SHIKE888/26h/B站 球杆平衡系统2026.07.29/产品实物图解.png

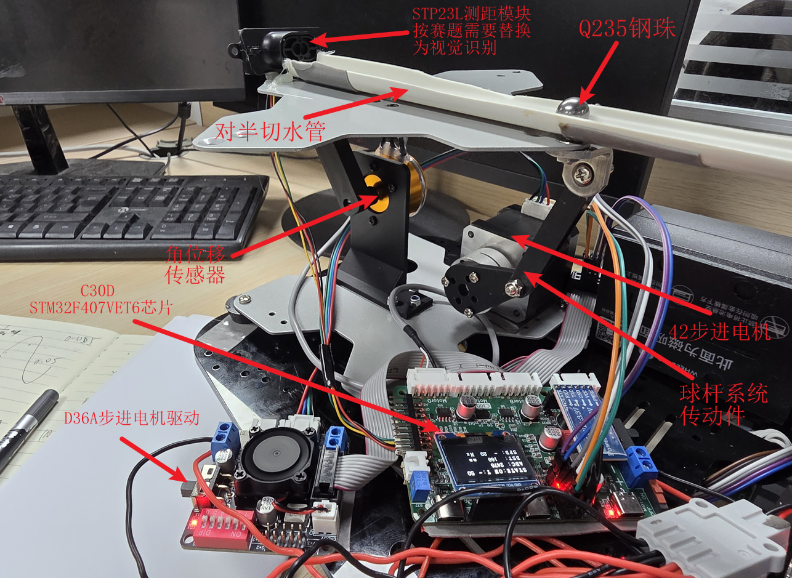
B站 球杆平衡系统2026.07.29/产品实物图解.png
