SHIKE888/26h/B站 球杆平衡系统2026.07.29/硬件方案与效果说明.txt

《球杆平衡控制系统》资料包里仅有球杆系统的代码，用到的物料如下
物料清单：
角位移传感器 * 1
1个42步进电机 * 1
D36A步进电机驱动 * 1
C30D控制板（STM32F407VET6芯片）* 1
STP23L测距模块 * 1
Q235钢珠 * 1
水管 * 1
球杆系统传动件 * 1

效果演示视频可以参考B站，可以改变球的位置，或者球收到干扰后可以回到原点：
https://www.bilibili.com/video/BV1CW3q6rEp6/?spm_id_from=333.1365.list.card_archive.click

巡线部分：
巡线部分的物料是单独的，此部分代码请查看四路红外模块的资料。巡线部分的物流如下，与球杆系统是分开的：
R3X电赛小车底盘 * 1
C30D控制板 * 1
LF04四路红外巡线模块 * 1

其他说明：
这套系统里，小车巡线和球杆平衡控制系统是分离的，两者无通信，是独立的系统。
