SHIKE888/26h/结构/连轴器.SLDPRT

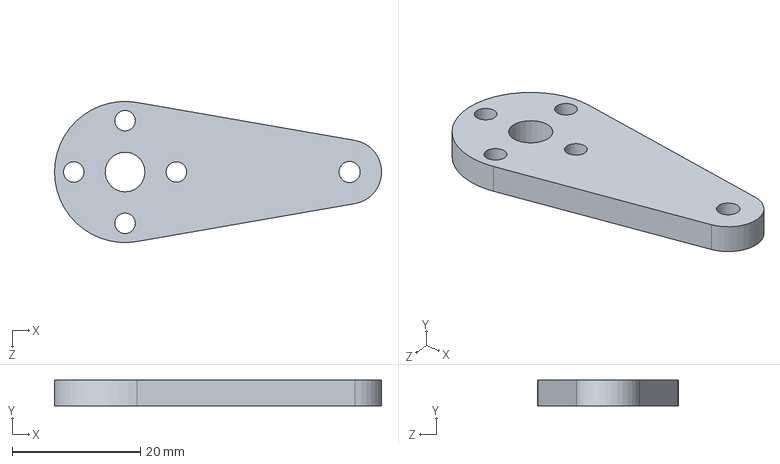
[picture p2: CAD file, 2026-07-30]
结构/连轴器.SLDPRT
51.0 x 4.00 x 22.0 mm
