SHIKE888/26h/结构/固定杆带底法兰.SLDPRT

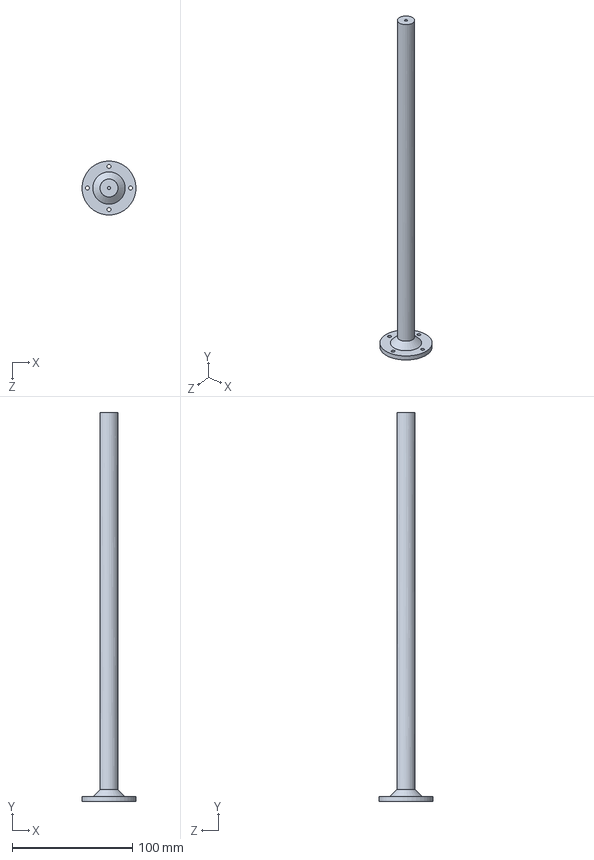
[picture p3: CAD file, 2026-07-29]
结构/固定杆带底法兰.SLDPRT
45.0 x 324.0 x 45.0 mm
