SHIKE888/26h/结构/顶法兰.SLDPRT

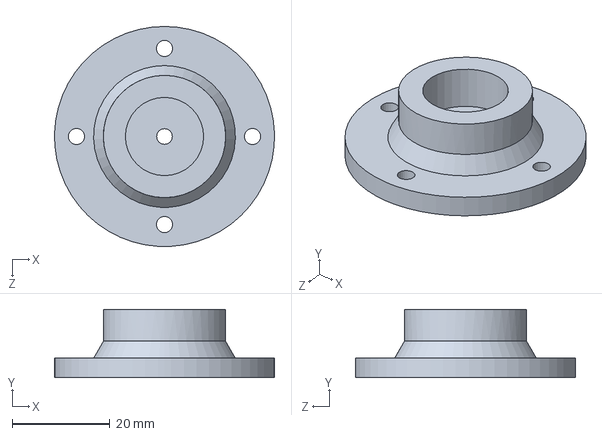
[picture p4: CAD file, 2026-07-29]
结构/顶法兰.SLDPRT
45.0 x 14.0 x 45.0 mm
