SHIKE888/26h/结构/H42装配.SLDPRT

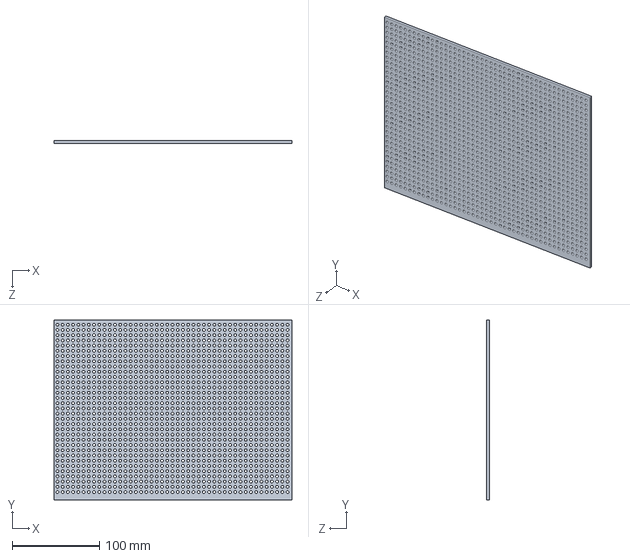
[picture p5: CAD file, 2026-07-29]
结构/H42装配.SLDPRT
273.0 x 206.0 x 3.00 mm
