SHIKE888/26h/结构/顶板.SLDPRT

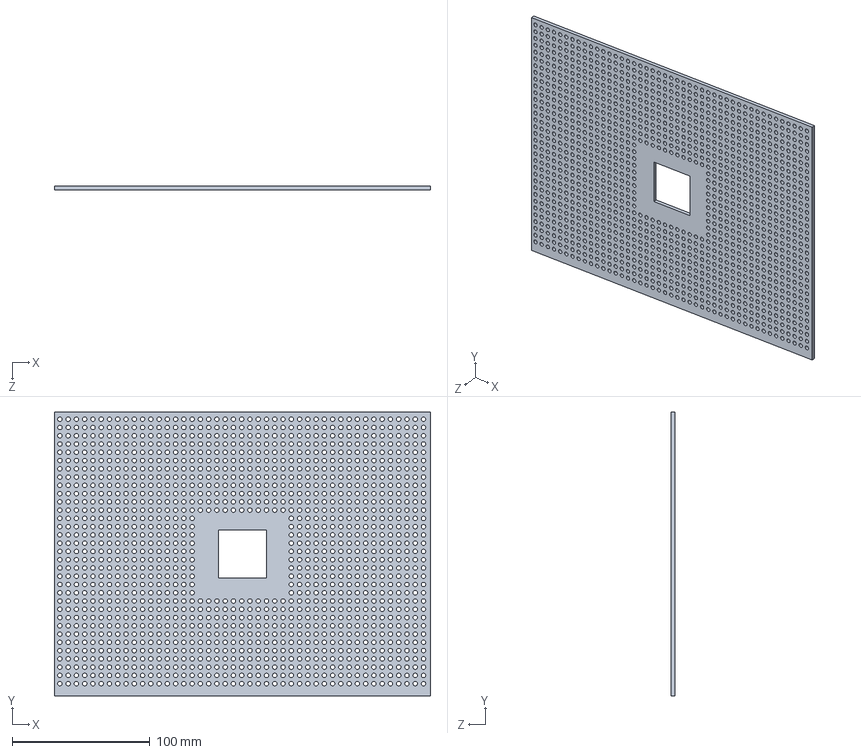
[picture p6: CAD file, 2026-07-29]
结构/顶板.SLDPRT
273.0 x 206.0 x 3.00 mm
