SHIKE888/26h/(list of files, cad)

Other CAD files:
结构/固定杆带底法兰.STL
结构/连轴器.STL
结构/顶板.STL
结构/顶法兰.STL
