SHIKE888/26h/B站 球杆平衡系统2026.07.29/球杆平衡控制系统/WHEELTEC.ioc

Mcu.UserName=STM32F407VETx
PA1.Signal=ADCx_IN1
PA10.Signal=USART1_RX
PA11.Signal=USB_OTG_FS_DM
PA12.Signal=USB_OTG_FS_DP
PA13.Signal=SYS_JTMS-SWDIO
PA14.Signal=SYS_JTCK-SWCLK
PA15.Signal=S_TIM2_CH1_ETR
PA8.GPIO_Label=UserBuzzer
PA8.Signal=GPIO_Output
PA9.Signal=USART1_TX
PB0.Signal=ADCx_IN8
PB1.Signal=ADCx_IN9
PB10.GPIO_Label=IIC_SCL
PB10.Signal=GPIO_Output
PB11.GPIO_Label=IIC_SDA
PB11.Signal=GPIO_Output
PB15.Signal=S_TIM12_CH2
PB3.Signal=S_TIM2_CH2
PB4.Signal=S_TIM3_CH1
PB5.Signal=S_TIM3_CH2
PB6.Signal=S_TIM4_CH1
PB7.Signal=S_TIM4_CH2
PB8.Signal=S_TIM10_CH1
PB9.Signal=S_TIM11_CH1
PB14.GPIO_Label=STEPPER_EN
PB14.Signal=GPIO_Output
PC12.Signal=UART5_TX
PC6.Signal=S_TIM8_CH1
PC8.GPIO_Label=STEPPER_DIR1
PC8.Signal=GPIO_Output
PD0.Signal=CAN1_RX
PD1.Signal=CAN1_TX
PD11.GPIO_Label=OLED_DC
PD11.Signal=GPIO_Output
PD12.GPIO_Label=OLED_RES
PD12.Signal=GPIO_Output
PD13.GPIO_Label=OLED_SDA
PD13.Signal=GPIO_Output
PD14.GPIO_Label=OLED_SCL
PD14.Signal=GPIO_Output
PD2.Signal=UART5_RX
PD3.GPIO_Label=ENKey
PD3.Signal=GPIO_Input
PD5.Signal=USART2_TX
PD6.Signal=USART2_RX
PD8.Signal=USART3_TX
PD9.Signal=USART3_RX
PE0.GPIO_Label=UserKEY
PE0.Signal=GPIO_Input
PE11.Signal=S_TIM1_CH2
PE13.Signal=S_TIM1_CH3
PE14.Signal=S_TIM1_CH4
PE5.Signal=S_TIM9_CH1
PE6.Signal=S_TIM9_CH2
PE8.GPIO_Label=UserLED
PE8.Signal=GPIO_Output
PE9.Signal=S_TIM1_CH1
PH0-OSC_IN.Signal=RCC_OSC_IN
PH1-OSC_OUT.Signal=RCC_OSC_OUT
