SHIKE888/26h/26H/Core/Inc/main.h

#define LED_Pin GPIO_PIN_13
#define LED_GPIO_Port GPIOC
#define KEY_Pin GPIO_PIN_0
#define KEY_GPIO_Port GPIOA
#define KEY_L_Pin GPIO_PIN_1
#define KEY_L_GPIO_Port GPIOA
#define TRACE0_Pin GPIO_PIN_4
#define TRACE0_GPIO_Port GPIOA
#define TRACE1_Pin GPIO_PIN_5
#define TRACE1_GPIO_Port GPIOA
#define TRACE2_Pin GPIO_PIN_6
#define TRACE2_GPIO_Port GPIOA
#define TRACE3_Pin GPIO_PIN_7
#define TRACE3_GPIO_Port GPIOA
#define TRACE4_Pin GPIO_PIN_0
#define TRACE4_GPIO_Port GPIOB
#define TRACE5_Pin GPIO_PIN_1
#define TRACE5_GPIO_Port GPIOB
#define TRACE6_Pin GPIO_PIN_2
#define TRACE6_GPIO_Port GPIOB
#define TRACE7_Pin GPIO_PIN_10
#define TRACE7_GPIO_Port GPIOB
#define MA1_Pin GPIO_PIN_12
#define MA1_GPIO_Port GPIOB
#define MA2_Pin GPIO_PIN_13
#define MA2_GPIO_Port GPIOB
#define MB1_Pin GPIO_PIN_14
#define MB1_GPIO_Port GPIOB
#define MB2_Pin GPIO_PIN_15
#define MB2_GPIO_Port GPIOB
#define KEY_R_Pin GPIO_PIN_8
#define KEY_R_GPIO_Port GPIOA
#define MB_PWM_Pin GPIO_PIN_15
#define MB_PWM_GPIO_Port GPIOA
#define MA_PWM_Pin GPIO_PIN_3
#define MA_PWM_GPIO_Port GPIOB
#define MA_ENCODER_A_Pin GPIO_PIN_4
#define MA_ENCODER_A_GPIO_Port GPIOB
#define MA_ENCODER_B_Pin GPIO_PIN_5
#define MA_ENCODER_B_GPIO_Port GPIOB
#define MB_ENCODER_A_Pin GPIO_PIN_6
#define MB_ENCODER_A_GPIO_Port GPIOB
#define MB_ENCODER_B_Pin GPIO_PIN_7
#define MB_ENCODER_B_GPIO_Port GPIOB
#define OLED_SCL_Pin GPIO_PIN_8
#define OLED_SCL_GPIO_Port GPIOB
#define OLED_SDA_Pin GPIO_PIN_9
#define OLED_SDA_GPIO_Port GPIOB
