SHIKE888/26h/26H/User/Motor/step_motor.c

/**
 * @file    step_motor.c
 * @brief   张大头 Emm_V4.2 步进电机驱动 — 角度模式实现 (USART6)
 * @author  shike888
 * @date    2026-07-31
 *
 * @note    参考 CSDN 文章: STM32步进闭环控制、速度控制（张大头Emm_V4.2驱动器）
 *          协议依据 ZDT_X42S Emm 固件 TTL 串口协议与命令格式
 */

#include "step_motor.h"
#include "usart.h"
#include <string.h>
#include <stdlib.h>

/* ========================================================================== *
 *  全局电机实例
 * ========================================================================== */

StepMotor g_step_motor;

/* ========================================================================== *
 *  静态辅助函数
 * ========================================================================== */

/**
 * @brief 计算校验并填入帧尾
 *        STEP_MOTOR_CHK_XOR=1: XOR 逐字节异或
 *        STEP_MOTOR_CHK_XOR=0: 固定 0x6B
 * @param data 帧缓冲区, data[len-1] 将被填入校验值
 * @param len  帧总长度
 */
static void StepMotor_CalcXOR(uint8_t *data, uint8_t len)
{
#if STEP_MOTOR_CHK_XOR
    uint8_t chk = 0;
    for (uint8_t i = 0; i < len - 1; i++)
        chk ^= data[i];
    data[len - 1] = chk;
#else
    data[len - 1] = STEP_MOTOR_CHK_DEFAULT;
#endif
}

/**
 * @brief 通过 USART6 发送位置模式指令帧 (13 字节, DMA 非阻塞)
 * @note  tx_buf 需保持有效到 DMA 完成（StepMotor 结构体成员，持久有效）
 */
/**
 * @brief 通过 USART6 发送位置指令 (DMA, 非等待)
 * @note  若 DMA 忙则跳过（调用方应保留 dirty 标志等待重试）
 * @retval 1=发送成功, 0=DMA忙未发送
 */
static uint8_t StepMotor_SendPositionCmd(StepMotor *motor)
{
    if (huart6.gState != HAL_UART_STATE_READY)
        return 0;
    StepMotor_CalcXOR(motor->tx_buf, 13);
    HAL_UART_Transmit_DMA(&huart6, motor->tx_buf, 13);
    return 1;
}

/**
 * @brief 通过 USART6 发送通用短指令 (阻塞模式, 栈缓冲区安全)
 */
static void StepMotor_SendCmd(uint8_t *data, uint8_t len)
{
    StepMotor_CalcXOR(data, len);
    HAL_UART_Transmit(&huart6, data, len, 100);
}

/* ========================================================================== *
 *  API 实现
 * ========================================================================== */

/**
 * @brief 步进电机初始化
 */
void StepMotor_Init(StepMotor *motor, uint8_t addr, uint16_t speed, uint8_t acc)
{
    memset(motor, 0, sizeof(StepMotor));
    motor->addr = addr;
    motor->speed = speed;
    motor->acc = acc;

    /* 构建默认 FD 帧 (13字节, 脉冲=0, 相对模式, 立即执行)
     * [0]=Addr [1]=FD [2]=Dir [3:4]=Speed [5]=Acc [6:9]=Pulse [10]=PosMode [11]=Sync [12]=Chk */
    motor->tx_buf[0] = addr;
    motor->tx_buf[1] = 0xFD;
    motor->tx_buf[2] = 0x00; /* Dir=CW */
    motor->tx_buf[3] = (speed >> 8) & 0xFF;
    motor->tx_buf[4] = speed & 0xFF;
    motor->tx_buf[5] = acc;
    motor->tx_buf[6] = 0x00;
    motor->tx_buf[7] = 0x00;
    motor->tx_buf[8] = 0x00;
    motor->tx_buf[9] = 0x00;  /* Pulse=0 */
    motor->tx_buf[10] = 0x00; /* PosMode=相对 */
    motor->tx_buf[11] = 0x00; /* Sync=立即 */
    motor->tx_buf[12] = STEP_MOTOR_CHK_DEFAULT;

    motor->now_angle = 0.0f;
}

/**
 * @brief 设置目标绝对角度
 * @note  内部自动计算与当前角度的差值，转换为脉冲后发送
 */
void StepMotor_SetAngle(StepMotor *motor, float angle)
{
    float error_angle = angle - motor->now_angle;

    if (error_angle == 0.0f)
        return;

    /* 角度 → 脉冲数 */
    int32_t pulse = (int32_t)(error_angle / 360.0f * STEP_MOTOR_PULSE_PER_CIRCLE);

    if (pulse == 0)
        return;

    /* 方向: Dir=00 CW, Dir=01 CCW (协议文档) */
    uint8_t dir = (pulse > 0) ? 0x00 : 0x01;
    uint32_t abs_pulse = (pulse > 0) ? (uint32_t)pulse : (uint32_t)(-pulse);

    /* FD 帧 13 字节:
     * [0]=Addr  [1]=FD   [2]=Dir   [3:4]=Speed(u16 Big-Endian)
     * [5]=Acc   [6:9]=Pulse(u32 Big-Endian)
     * [10]=PosMode(00=相对)  [11]=Sync(00=立即)  [12]=Chk */
    motor->tx_buf[0] = motor->addr;
    motor->tx_buf[1] = 0xFD;
    motor->tx_buf[2] = dir;
    motor->tx_buf[3] = (motor->speed >> 8) & 0xFF;
    motor->tx_buf[4] = motor->speed & 0xFF;
    motor->tx_buf[5] = motor->acc;
    motor->tx_buf[6] = (abs_pulse >> 24) & 0xFF;
    motor->tx_buf[7] = (abs_pulse >> 16) & 0xFF;
    motor->tx_buf[8] = (abs_pulse >> 8) & 0xFF;
    motor->tx_buf[9] = abs_pulse & 0xFF;
    motor->tx_buf[10] = 0x00; /* 相对上一目标 */
    motor->tx_buf[11] = 0x00; /* 立即执行 */
    /* Chk 由 StepMotor_SendPositionCmd 填入 */

    if (StepMotor_SendPositionCmd(motor))
    {
        motor->now_angle = angle; /* 只有成功发送后才更新 */
    }
}

/**
 * @brief 电机使能/失能
 * @note  帧格式: [Addr] [F3] [AB] [Enable] [Sync] [Chk]
 */
void StepMotor_Enable(StepMotor *motor, uint8_t enable)
{
    uint8_t cmd[6];
    cmd[0] = motor->addr;
    cmd[1] = 0xF3;
    cmd[2] = 0xAB;
    cmd[3] = enable ? 0x01 : 0x00;
    cmd[4] = 0x00; /* 立即执行 */
    cmd[5] = STEP_MOTOR_CHK_DEFAULT;

    StepMotor_SendCmd(cmd, 6);
}

/**
 * @brief 立即停止电机
 * @note  帧格式: [Addr] [FE] [98] [Sync] [Chk]
 */
void StepMotor_Stop(StepMotor *motor)
{
    uint8_t cmd[5];
    cmd[0] = motor->addr;
    cmd[1] = 0xFE;
    cmd[2] = 0x98;
    cmd[3] = 0x00; /* 立即执行 */
    cmd[4] = STEP_MOTOR_CHK_DEFAULT;

    StepMotor_SendCmd(cmd, 5);
}

/**
 * @brief 设置电机转速
 */
void StepMotor_SetSpeed(StepMotor *motor, uint16_t speed)
{
    motor->speed = speed;
}

/**
 * @brief 设置电机加速度
 */
void StepMotor_SetAcc(StepMotor *motor, uint8_t acc)
{
    motor->acc = acc;
}

/**
 * @brief 当前位置清零 (硬件归零)
 * @note  帧格式: [Addr] [0A] [6D] [Chk]
 */
void StepMotor_ZeroPosition(StepMotor *motor)
{
    uint8_t cmd[4];
    cmd[0] = motor->addr;
    cmd[1] = 0x0A;
    cmd[2] = 0x6D;
    cmd[3] = STEP_MOTOR_CHK_DEFAULT;

    StepMotor_SendCmd(cmd, 4);

    /* 软件角度同步归零 */
    motor->now_angle = 0.0f;
}

/**
 * @brief 触发回零 — 回到绝对坐标零点
 * @note  帧格式: [Addr] [9A] [HomeMode=04] [Sync=00] [Chk]
 *        HomeMode=04 表示回到绝对坐标零点
 *        回零过程中电机会旋转, 完成后自动停止在零点
 */
void StepMotor_Home(StepMotor *motor)
{
    uint8_t cmd[5];
    cmd[0] = motor->addr;
    cmd[1] = 0x9A;
    cmd[2] = 0x04; /* 回到绝对坐标零点 */
    cmd[3] = 0x00; /* 立即执行 */
    cmd[4] = STEP_MOTOR_CHK_DEFAULT;

    StepMotor_SendCmd(cmd, 5);

    /* 软件角度同步归零 */
    motor->now_angle = 0.0f;
}
