SHIKE888/26h/26H/User/Task/ball_balance.h

/**
 * @file    ball_balance.h
 * @brief   钢球平衡控制系统 (PID + 步进电机)
 *
 * 控制链路:
 *   K230 x坐标 → EMA滤波 → PD控制器 → 步进电机角度 → 管道倾斜 → 钢球滚动
 *
 * 方向约定:
 *   CCW (负角度) → 管道右倾 → 球右滚
 *    CW (正角度) → 管道左倾 → 球左滚
 *
 * 限位: ±15° (防止机械碰撞)
 */

#ifndef BALL_BALANCE_H_
#define BALL_BALANCE_H_

#include "stm32f4xx_hal.h"

/* ---- PID 参数 (可在线调整) ---- */
#define BAL_KP 0.01f /* 比例增益 (deg/pixel) */
#define BAL_KD 8.0f  /* 微分增益 */
#define BAL_KI 0.06f /* 积分增益 (小值, 消除稳态误差) */

/* ---- 滤波器 ---- */
#define BAL_EMA_ALPHA 0.60f /* EMA 平滑系数 (0~1, 越小越平滑) */

/* ---- 限位 ---- */
#define BAL_ANGLE_MAX 30.0f  /* 最大倾斜角 (°) */
#define BAL_ANGLE_MIN -28.0f /* 最小倾斜角 (°) */

/* ---- 控制周期 (ms) ---- */
#define BAL_CTRL_PERIOD_MS 10

/* ---- 目标丢失超时 (ms), 超时后缓慢回零 ---- */
#define BAL_TIMEOUT_MS 500

/* ---- 电机参数 ---- */
#define BAL_MOTOR_SPEED 300 /* 转速 (RPM) */
#define BAL_MOTOR_ACC 0x80  /* 加速度 — 平滑响应 */

/* ---- 前馈参数 ---- */
#define BAL_FF_K 1.0f         /* 加速度前馈系数 */
#define BAL_FF_DEADBAND 0.01f /* 死区: |accel|低于此值不补偿 */

/* ---- F2 纯开环控制参数 (时间序列, 完全不依赖PID反馈) ---- */
#define BAL_DEMO_ANGLE_LEFT 8.0f  /* 左倾角度 (°) */
#define BAL_DEMO_TILT_LEFT 180   /* 左倾持续时间 (ms) */
#define BAL_DEMO_PAUSE1_MS 360/* 第一次回正等待 (ms) */
#define BAL_DEMO_ANGLE_RIGHT -12.0f /* 右倾角度 (°, 负值=右倾) */
#define BAL_DEMO_TILT_RIGHT 450   /* 右倾持续时间 (ms) */
#define BAL_DEMO_SPEED_CAP 100    /* 电机上限RPM */
#define BAL_DEMO_SPEED_CAP 100   /* 电机上限RPM */

/* F2 目标与容差 */
#define BAL_DEMO_TARGET_POS 5.0f  /* 目标位置 +5cm */
#define BAL_DEMO_TARGET_NEG -5.0f /* 目标位置 -5cm */
#define BAL_DEMO_MAX_LIMIT 6.0f   /* 最大位移限制 (cm) */
#define BAL_DEMO_TOLERANCE 0.8f   /* 到达容差 (cm) */

/* ---- F5 自定义目标采样 ---- */
#define BAL_CUSTOM_SAMPLE_COUNT 10 /* 采样次数 */
#define BAL_CUSTOM_SAMPLE_MS 50    /* 采样间隔 (ms) */

/* ---- F2 自主演示阶段 ---- */
typedef enum
{
    BAL_DEMO_IDLE = 0, /* 等待启动 */
    BAL_DEMO_TO_POS,   /* 移向 +5cm */
    BAL_DEMO_BAL_POS,  /* 平衡在 +5cm */
    BAL_DEMO_TO_NEG,   /* 移向 -5cm */
    BAL_DEMO_BAL_NEG,  /* 平衡在 -5cm */
} BallDemoPhase;

/* ---- 初始化 ---- */
void BallBalance_Init(float target_x);

/* ---- 动态设置目标位置 ---- */
void BallBalance_SetTarget(float target_x);

/* ---- 设置前馈加速度 (由底盘提供, 单位: cm/s²) ---- */
void BallBalance_SetFeedforward(float accel);

/* ---- 主控制循环 (在 TIM1 10ms 回调中调用) ---- */
void BallBalance_Tick(void);

/* ---- 暂停/恢复平衡控制 ---- */
void BallBalance_Pause(void);
void BallBalance_Resume(void);
uint8_t BallBalance_IsPaused(void);

/* ---- 发送电机指令 (在主循环中调用, 不能在中断中调用) ---- */
void BallBalance_SendMotorCmd(void);

/* ---- 获取当前状态 (供 OLED 显示) ---- */
float BallBalance_GetAngle(void);
float BallBalance_GetFilteredX(void);
int32_t BallBalance_GetError(void);

#endif /* BALL_BALANCE_H_ */
