SHIKE888/26h/B站 球杆平衡系统2026.07.29/球杆平衡控制系统/WHEELTEC_APP/appshow_task.c

//HAL Lib Include File
#include "usart.h"

//C Include File
#include <stdio.h>
#include <string.h>

//FreeRTOS Include File
#include "FreeRTOS.h"
#include "task.h"

//BSP Include File
#include "bsp_icm20948.h"

//APP Include File
#include "BlueTooth_task.h"
#include "robot_select_init.h"
#include "RobotControl_task.h"

static char page1_paramshow[100];   //APP首页数据
static char page2_paramshow[512];  //APP波形页面数据
static char page3_paramshow[512];  //APP参数页面数据

static int voltage_to_percentage(float voltage) {
    const float V_MIN = 10.0f;  // 最小电压 (0%)
    const float V_MAX = 12.5f; // 最大电压 (100%)
    
    // 确保电压在有效范围内
    if (voltage < V_MIN) return 0;
    if (voltage > V_MAX) return 100;
    
    // 线性插值计算百分比并取整
    int percentage = (int)(((voltage - V_MIN) / (V_MAX - V_MIN)) * 100.0f + 0.5f); // 四舍五入
	
	if( percentage > 100 ) percentage = 100;
	if( percentage <= 0 ) percentage = 0;
	
    return percentage;
}

void APPshow_task(void* param)
{
	//获取时基,用于辅助任务能按固定频率运行
	TickType_t preTime = xTaskGetTickCount();
	
	//本任务的控制频率,单位为Hz
	const uint16_t TaskFreq = 20;
	
	//实现APP数据分时显示
	uint8_t appshowNum = 0;
	char* NeedShowBuf = NULL;
	
	while(1)
	{	
		int showLeftWheel=0,showRightWheel=0,VolPercen=0;
		
		switch(RobotHardWareParam.CarType)
		{
			case Omni_Car:
				showLeftWheel = RobotControlParam.MotorB.feedback*1000;
				showRightWheel = RobotControlParam.MotorC.feedback*1000;
				break;
			case Mec_Car:case Mec_Car_V550:
			case FourWheel_Car:case FourWheel_Car_V550:
				showLeftWheel = RobotControlParam.MotorA.feedback*1000;
				showRightWheel = RobotControlParam.MotorD.feedback*1000;
				break;
		}
		
		//电池电压百分比
		VolPercen = voltage_to_percentage(RobotControlParam.Vol);
		
		//APP显示数据
		appshowNum++; //分时显示
		if( 1 == appshowNum )
		{
			sprintf(page1_paramshow,"{A%d:%d:%d:%d}$",showLeftWheel,showRightWheel,VolPercen,(int)AttitudeVal.yaw); //左码盘,右码盘,电量百分比,角度
			NeedShowBuf = page1_paramshow;
		}
		else if( 2 == appshowNum )
		{
			appshowNum = 0;
			sprintf(page2_paramshow,"{B%d:%d:%d}$",(int)AttitudeVal.pitch,(int)AttitudeVal.roll,(int)AttitudeVal.yaw); //波形显示
			NeedShowBuf = page2_paramshow;
		}
		
		//APP获取数据请求
		if( wheeltecApp.reportparam == 1 )
		{
			wheeltecApp.reportparam = 0;
			sprintf(page3_paramshow,"{C%d:%d:%d:%d:%d:%d:%d:%d:%d}$",
			 (int)RobotControlParam.defalutSpeed,
			 (int)RobotControlParam.kp,
			 (int)RobotControlParam.ki,
			 (int)RobotControlParam.LineDiffParam,
		      0,0,0,0,0); 
	
			NeedShowBuf = page3_paramshow;
		}
		
		//APP数据发送
		HAL_UART_Transmit_DMA(&huart2,(uint8_t*)NeedShowBuf,strlen(NeedShowBuf));
		
		/* 延迟指定频率 */
		vTaskDelayUntil(&preTime,pdMS_TO_TICKS( (1.0f/(float)TaskFreq)*1000) );
	}
	
}
