SHIKE888/26h/26H/User/OLED/oledfont.h

/**
 * @file    oledfont.h
 * @brief   字库与动画位图数据声明
 * @license MIT
 */

#ifndef OLED_OLEDFONT_H_
#define OLED_OLEDFONT_H_

/* ---- ASCII 字库 ---- */
extern const unsigned char F6x8[][6]; /**< 6×8 字体 */
extern const unsigned char F8X16[];   /**< 8×16 字体 */
extern const unsigned char Hzk[][32]; /**< 16×16 中文字库 */

#endif /* OLED_OLEDFONT_H_ */
