SHIKE888/26h/(commit log)

2026-07-29 修复定时器中断
2026-07-30 2问完美
    [连轴器.SLDPRT, 连轴器.STL]
2026-07-31 第三问底层
2026-07-31 pid还行
2026-07-31 基本完成六题，待继续优化
2026-07-31 修复一处笔误
2026-07-31 话可以的一版
2026-07-31 全部做完，有点小bug
2026-08-01 最终完赛版
